lpkha21/lidarDrone/batteryHolder.SLDPRT

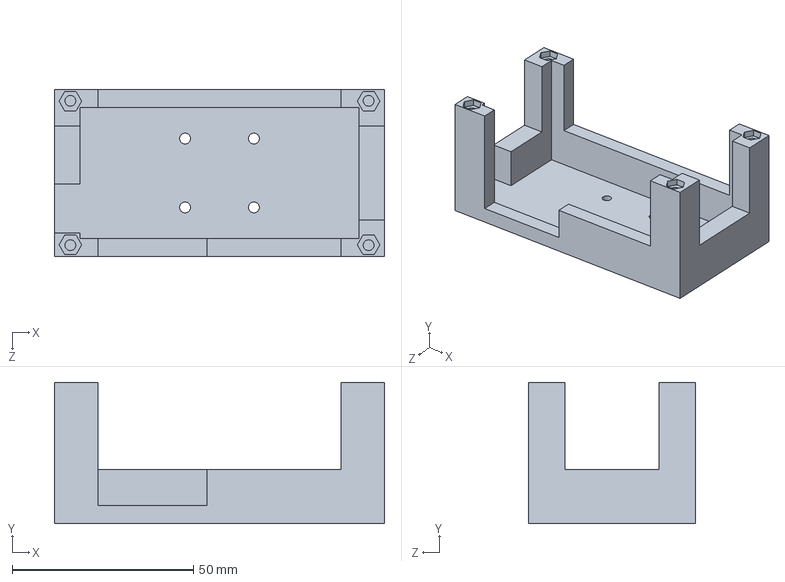
[picture p14: CAD file, 2024-09-16]
batteryHolder.SLDPRT
91.0 x 39.0 x 46.0 mm
