lpkha21/lidarDrone/batteryHolderTop.SLDPRT

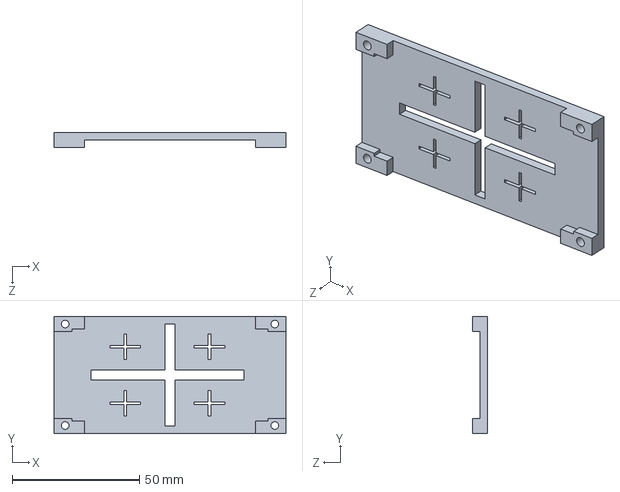
[picture p15: CAD file, 2024-09-16]
batteryHolderTop.SLDPRT
91.0 x 46.0 x 6.00 mm
