lpkha21/lidarDrone/test.SLDPRT

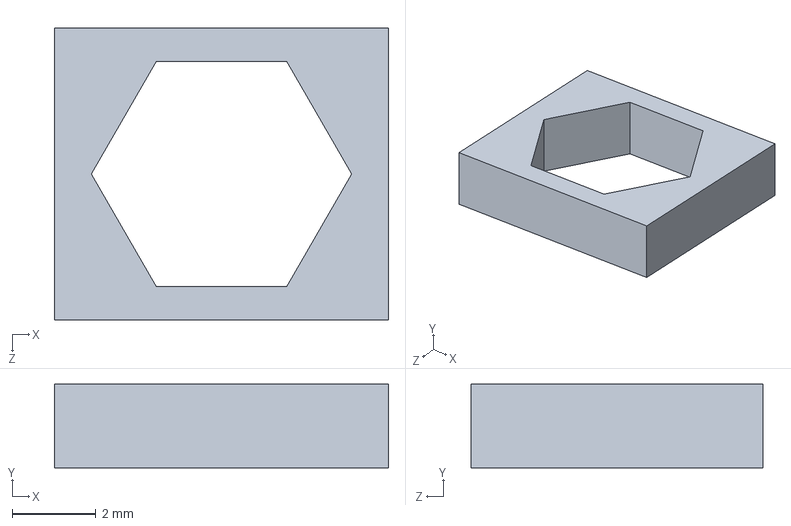
[picture p16: CAD file, 2024-09-16]
test.SLDPRT
8.00 x 2.00 x 7.00 mm
