lpkha21/lidarDrone/(list of files, cad)

Other CAD files:
batteryHolder.STL
batteryHolderTop.STL
test.STL
