lpkha21/lidarDrone/(commit log)

2024-09-16 added lidarData proccess code
2024-09-18 added receiver side code for esp32
